DrAtomic/industry-design/README.md

Electronic Hot and cold game

[wiki](https://github.com/DrAtomic/industry-design/wiki)

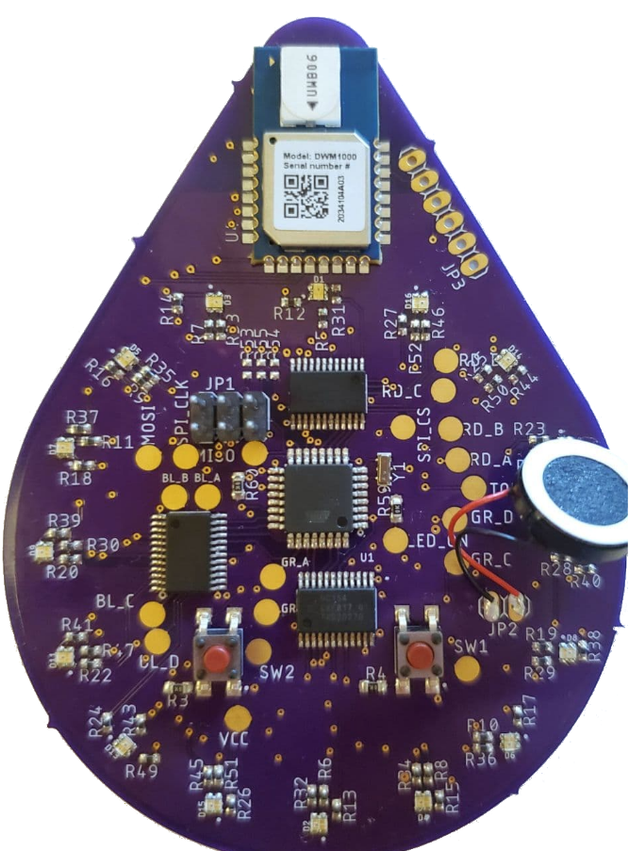
[picture p1: board.png]
board
