DrAtomic/industry-design/slides.pdf

# Electronic Hot and Cold Game

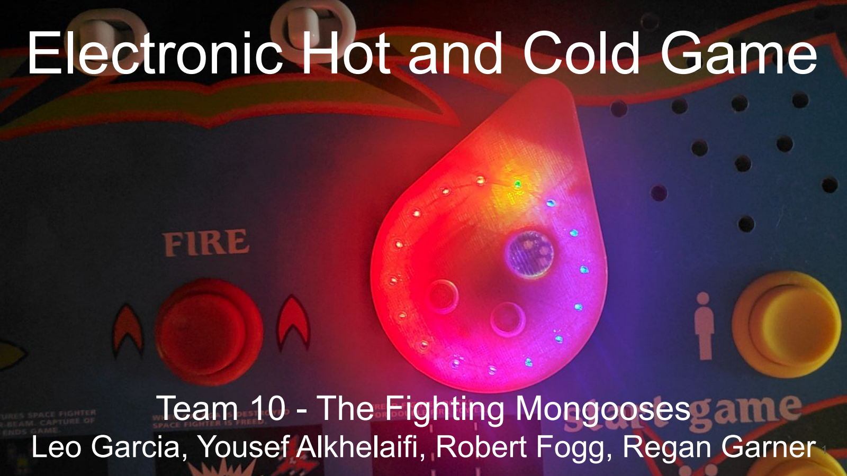
[picture p2: page 1]

# Team 10 - The Fighting Mongooses

# Leo Garcia, Yousef Alkhelaifi, Robert Fogg, Regan Garner 1

# The Problem

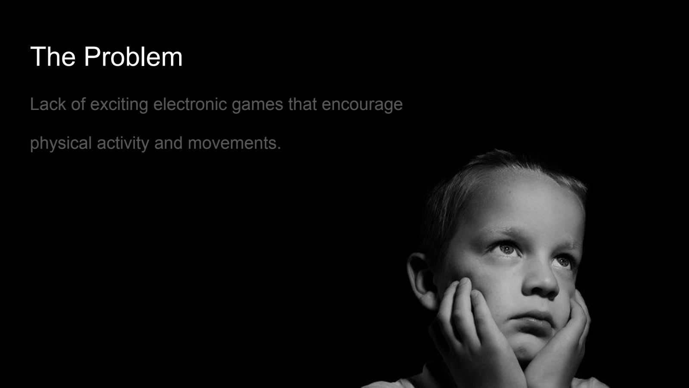
[picture p3: page 2]

## Lack of exciting electronic games that encourage

physical activity and movements.

# Objective: Make an electronic version of the “hot and cold” game

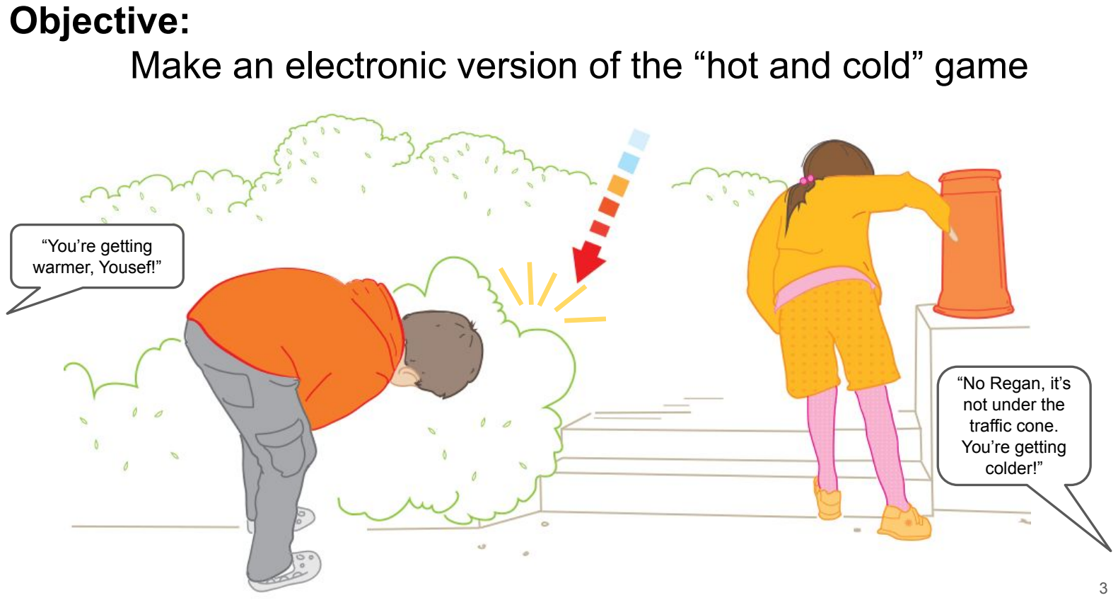
[picture p4: page 3]

“You’re getting
warmer, Yousef!”

“No Regan, it’s
not under the
traffic cone.
You’re getting
colder!”

# Solution

## A portable tracker that can

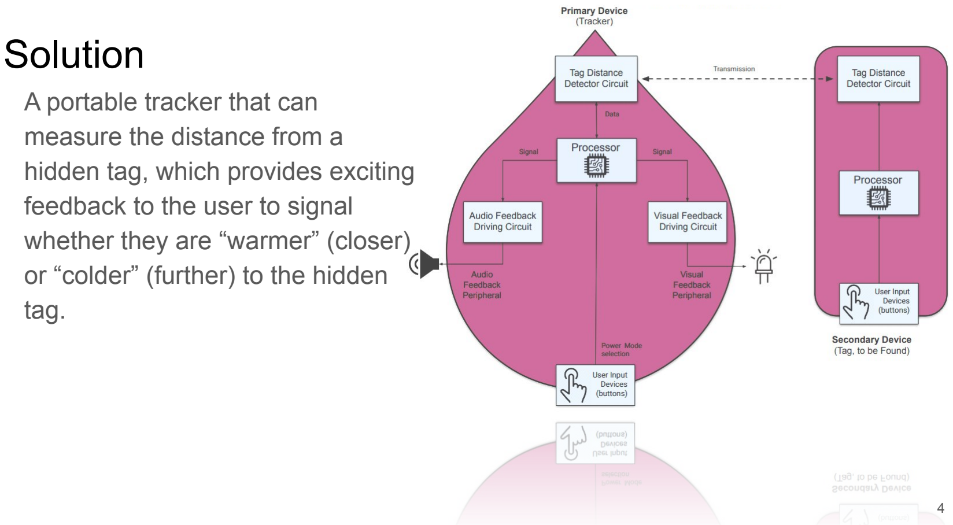
[picture p5: page 4]

## measure the distance from a hidden tag, which provides exciting feedback to the user to signal whether they are “warmer” (closer) or “colder” (further) to the hidden

tag.

# Alternatives:

## Pokemon Go, Geocaching, MicroFox Transmitter Hunting Kits

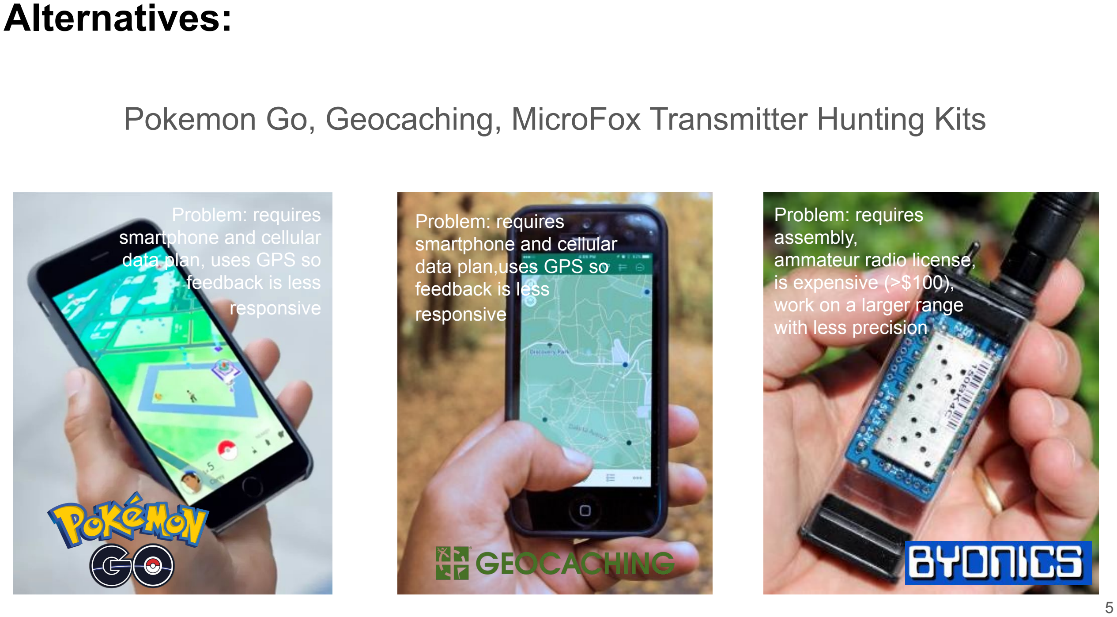
[picture p6: page 5]

Problem: requires
smartphone and cellular
data plan, uses GPS so
feedback is less
responsive

Problem: requires
assembly,
ammateur radio license,
is expensive (>$100),
work on a larger range
with less precision

Problem: requires
smartphone and cellular
data plan,uses GPS so
feedback is less
responsive

# Requirements

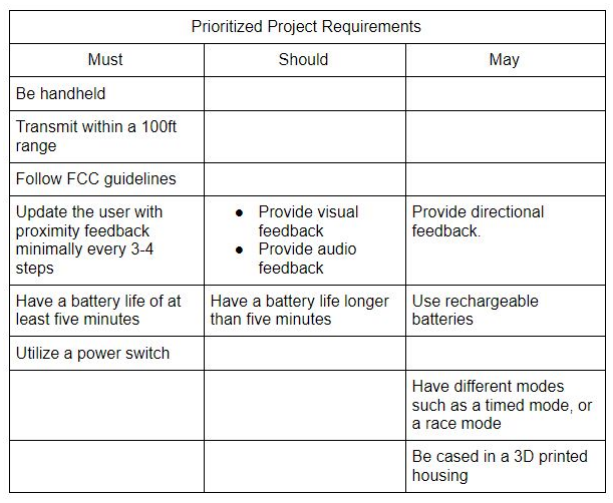
[picture p7: figure]

# Our Approach

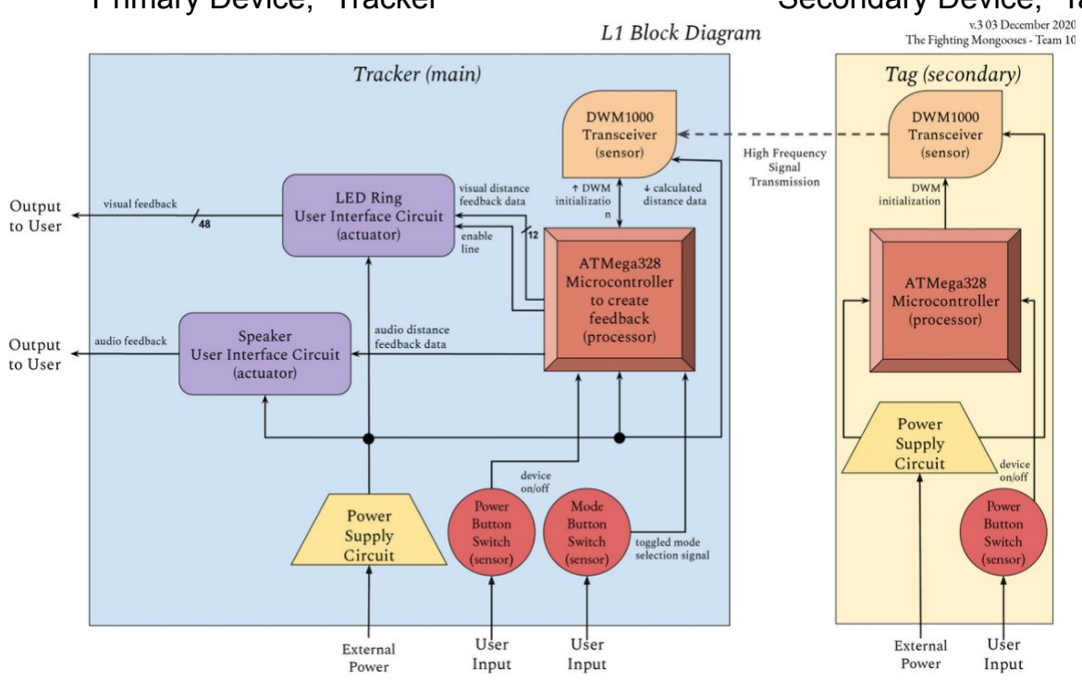
[picture p8: figure]

Primary Device, “Tracker” | Secondary Device, “Tag”

# Design: Power Supply Module

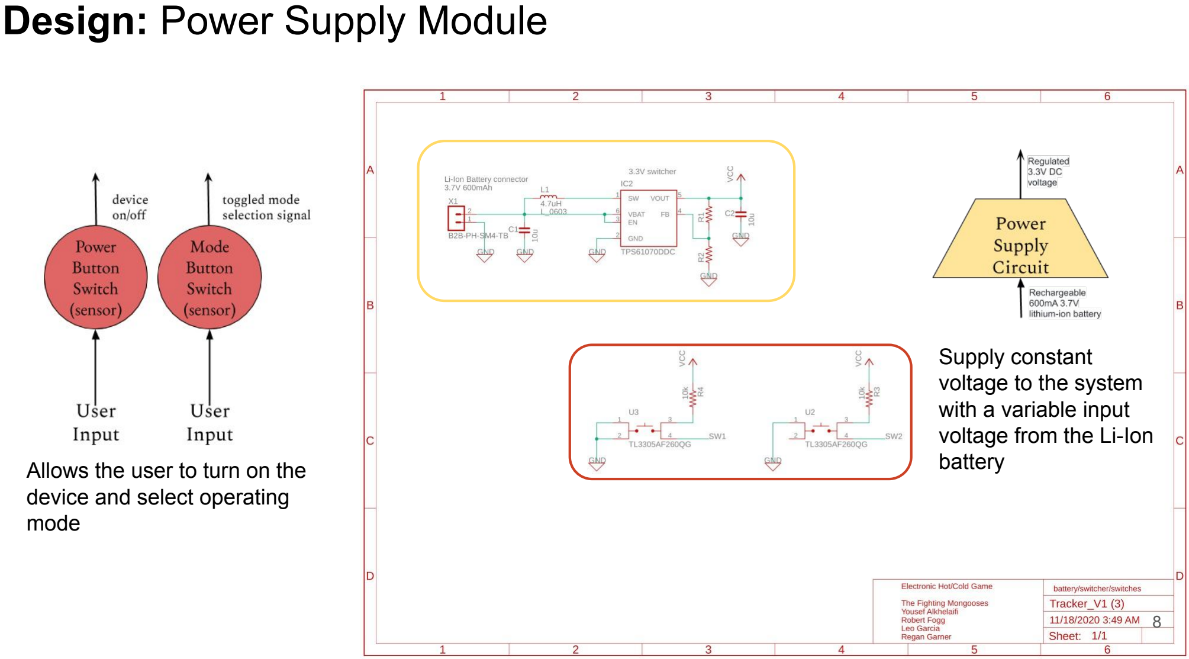
[picture p9: page 8]

Allows the user to turn on the device and select operating mode

Supply constant
voltage to the system
with a variable input
voltage from the Li-Ion
battery

# Design: Processor and Ranging Modules

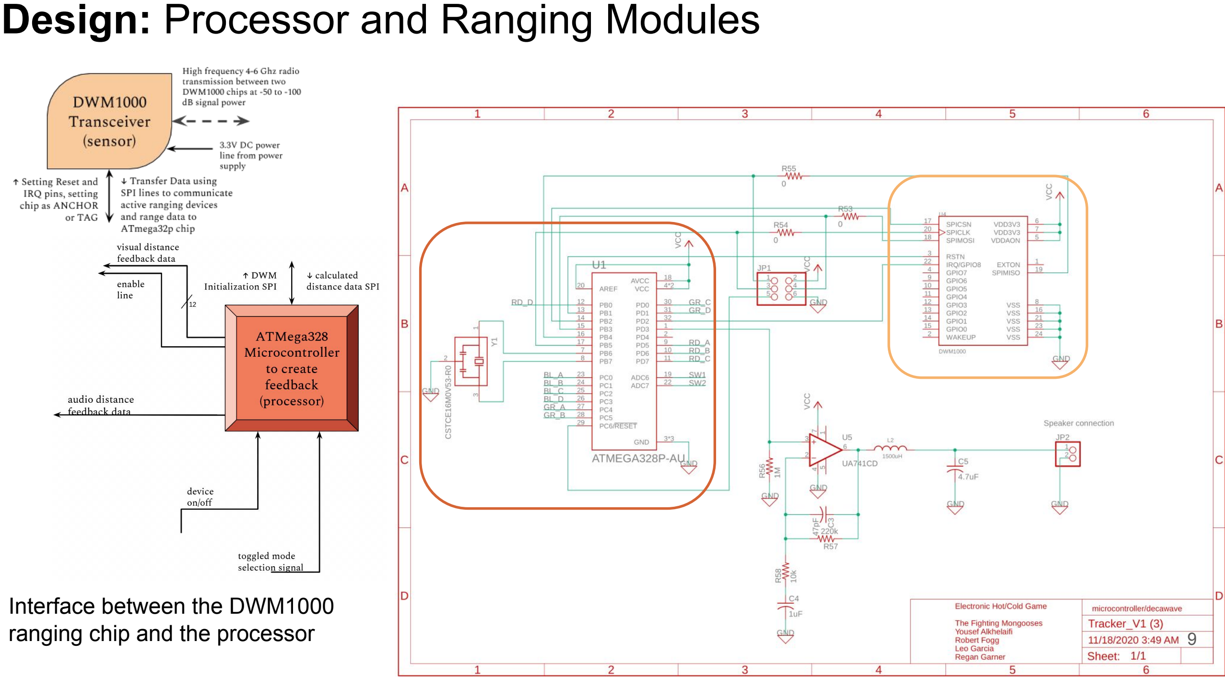
[picture p10: page 9]

Interface between the DWM1000 ranging chip and the processor

# Design: Visual Feedback

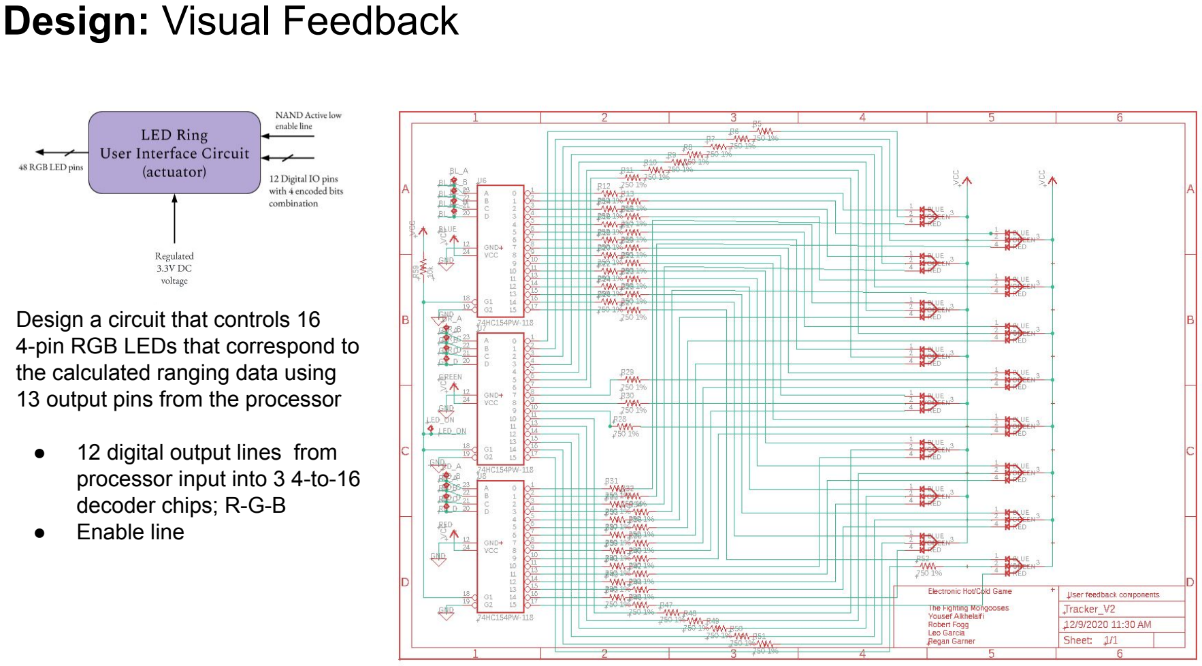
[picture p11: page 10]

Design a circuit that controls 16 4-pin RGB LEDs that correspond to the calculated ranging data using 13 output pins from the processor

- 12 digital output lines from processor input into 3 4-to-16 decoder chips; R-G-B
- Enable line

# Design: Audio Feedback

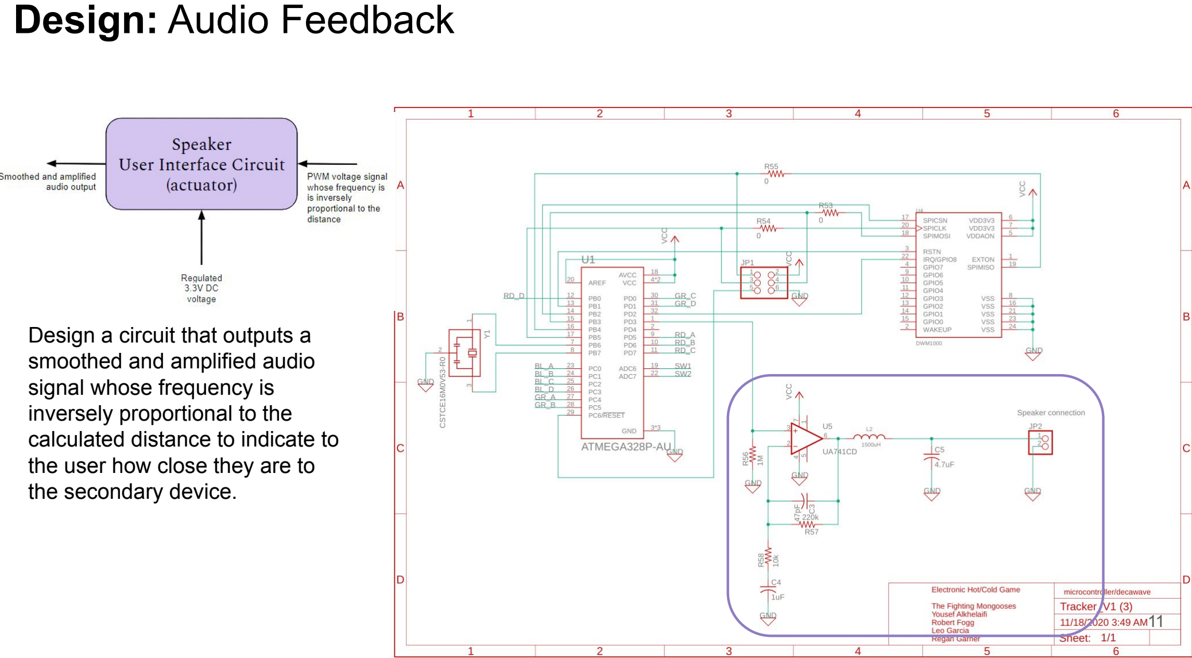
[picture p12: page 11]

Design a circuit that outputs a smoothed and amplified audio signal whose frequency is
inversely proportional to the calculated distance to indicate to the user how close they are to the secondary device.

# Design: Firmware

Challenges:

- Use the DW1000 two-way ranging capabilities to provide stable and usable range data for user feedback, using Dw1000 library.
- Design code that will drive 16 LEDs using 4 pins. By sending 4-bit word to 4x16 decoder, Make the code modular so it can be repeated for all 3 decoders to drive each color of the RGB LED array.
- LED code must be able to select individual LEDs to activate, as well as activate multiple LEDs simultaneously by rotating the selected LEDs in a counter-clock fashion With high enough frequency to appear continuous to the user
- Code must allow the user to interface via 2 buttons
- Driving Speaker with ranging data to be lower at greater distances and higher at closer distance.
LED Feedback Code | Speaker Feedback Code

Arduino-DW1000
interfacing code

Ranging Data

Digital write 4-bit words LED address to Decoder pins, with proper timing.

Output Square wave tone
inversely proportional with distance in frequency

2 Button
interfacing
code

Boolean
conditions

# Implementation: Prototyping

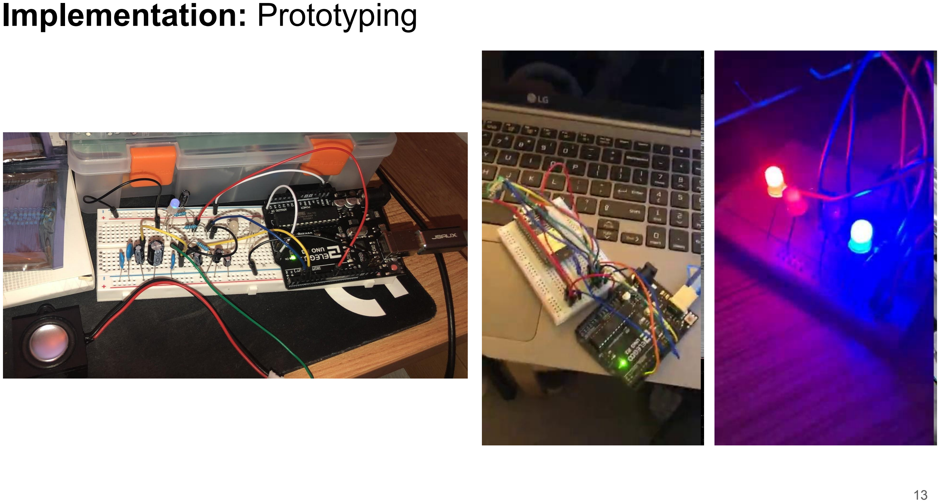
[picture p13: page 13]

# Design: PCB Layout

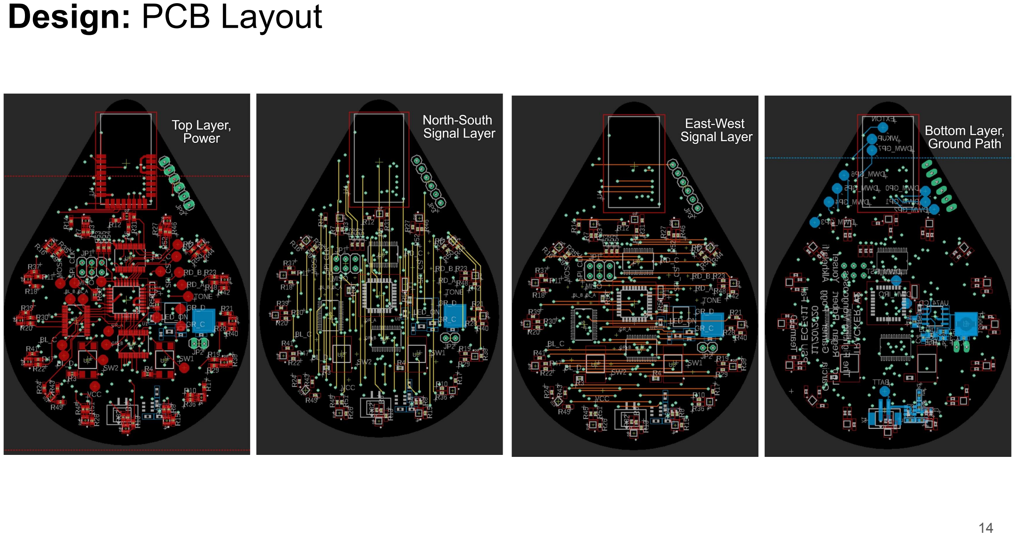
[picture p14: page 14]

# Implementation: Fabricated Boards

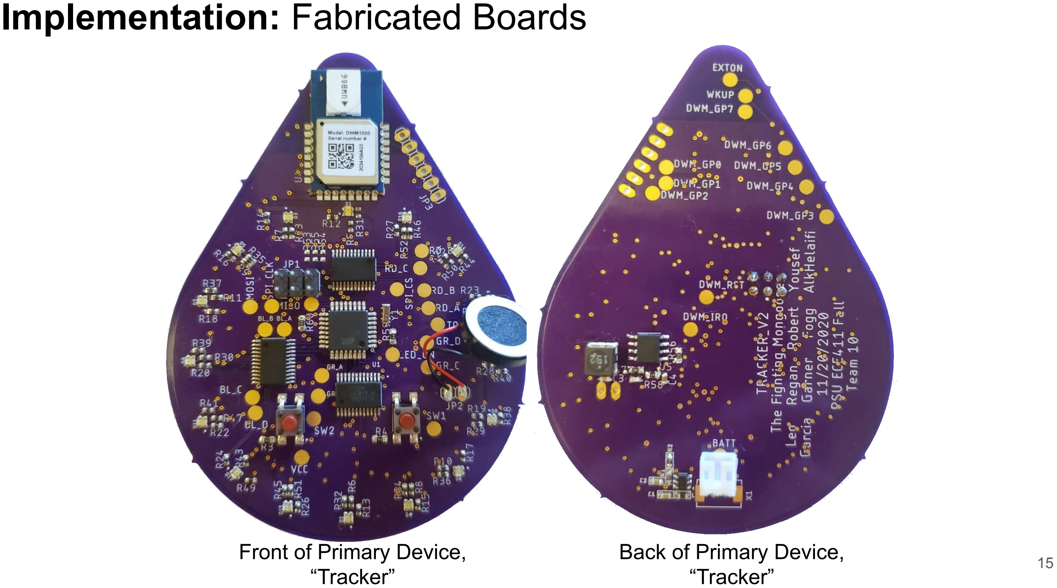
[picture p15: page 15]

Front of Primary Device,
“Tracker”

Back of Primary Device,
“Tracker”

# Implementation: Bill of Materials

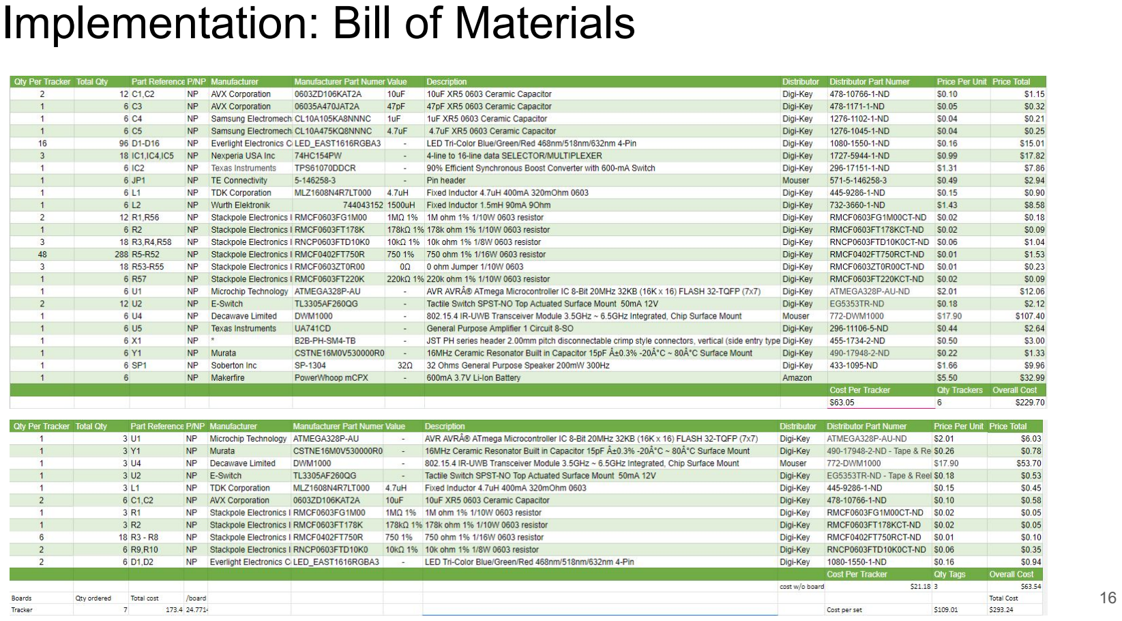
[picture p16: page 16]

# Testing & Results: LED & Speaker functionality

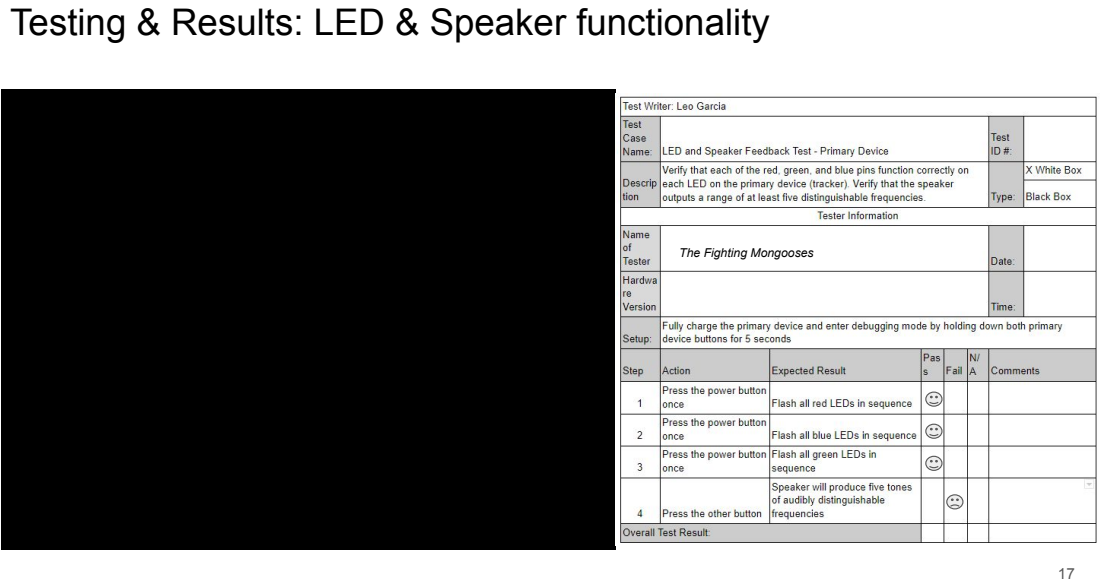
[picture p17: page 17]

The Fighting Mongooses

# Testing & Results: Visual Range Accuracy

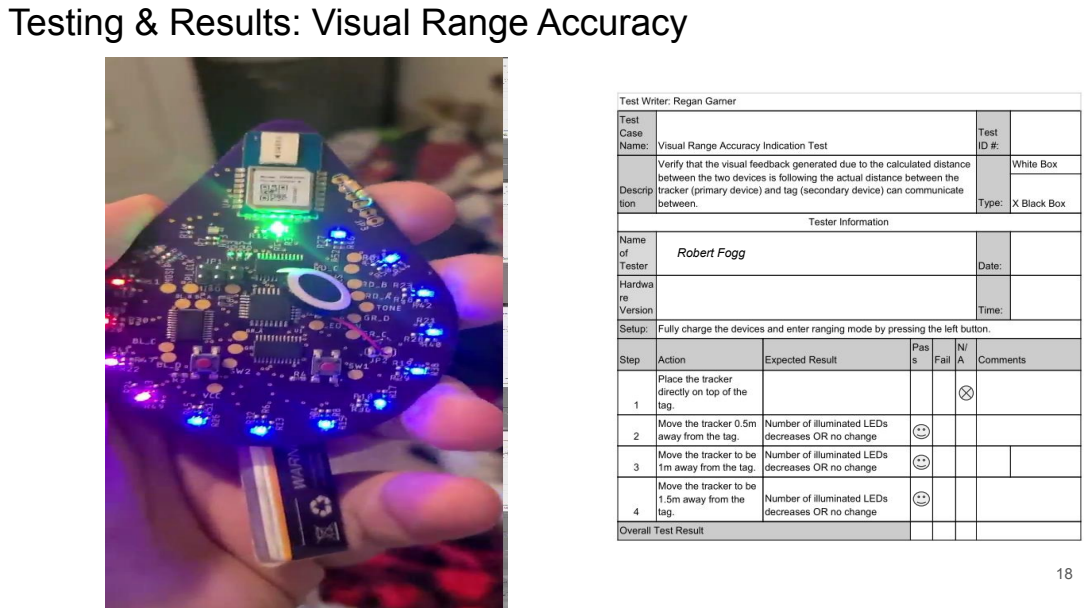
[picture p18: page 18]
Robert Fogg

# Failed Solutions:

## - RF time of flight calculation using simple antenna and Arduino

- (does not work because processor is not fast enough)

## - RSSI relating signal strength to distance using Arduino

- (doesn’t work because there’s too much noise at the legally allowed bandwidth)

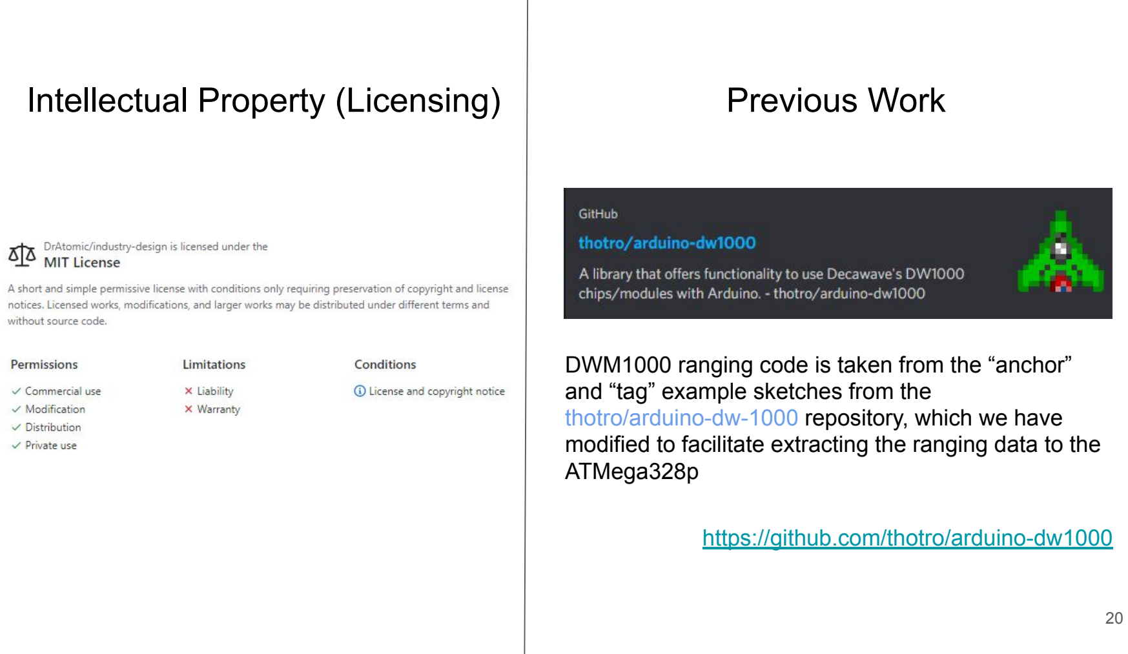
[picture p19: figure]
Intellectual Property (Licensing); and “tag” example sketches from the; ATMega328p; Previous Work

https://github.com/thotro/arduino-dw1000

DWM1000 ranging code is taken from the “anchor”

thotro/arduino-dw-1000 repository, which we have modified to facilitate extracting the ranging data to the

# Contributions

Yousef | Robert | Leo | Regan
- Designed audio
feedback circuit
- Designed visual
feedback circuit
- Wrote feedback
firmware
- Prototyping
- Implementing final
device
- Debugging firmware
- Finalized CAD
schematic
- Finalized CAD PCB
design
- Attached surface
mount components
- Designed and
manufactured 3D
printed cases
- Implementing final
device
- Debugging firmware
- Taught teammates how
to use GitHub
- Initial antenna design
- Managed GitHub
- Contributed to writing
feedback firmware
- Implementing final
device
- Debugging firmware
- Documentation
- Managed Team Wiki
- Initial filter design
- CAD schematic for
initial antenna & filter
design
- CAD schematic rough
draft
- Implementing final
device
- Debugging firmware

# Thank You!

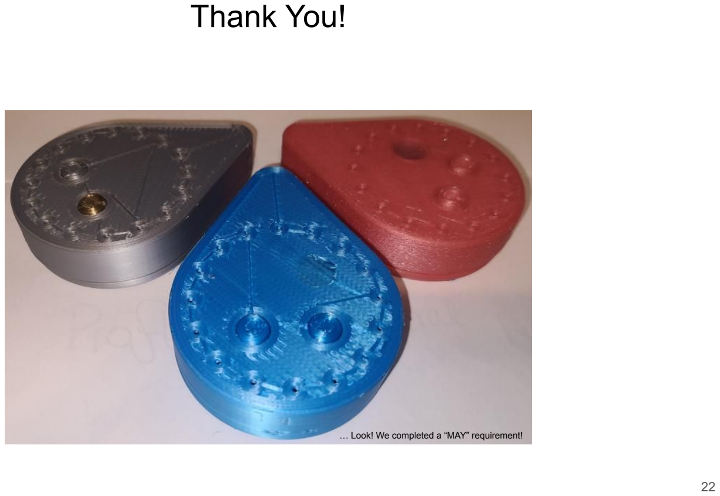
[picture p20: page 22]

… Look! We completed a “MAY” requirement!
