DrAtomic/industry-design/Firmware/LED Sequence Output.PNG

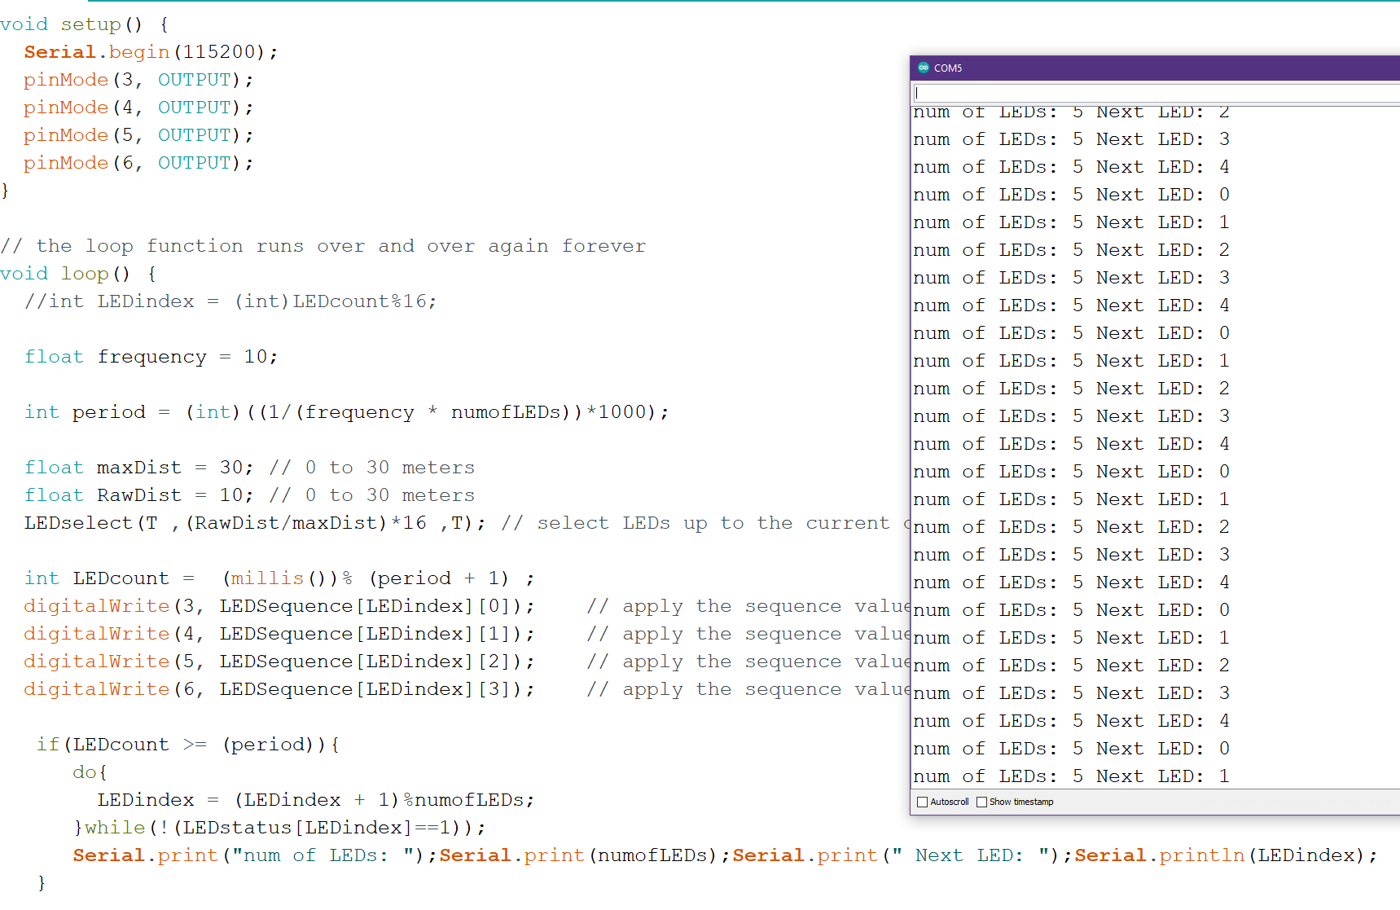
Firmware/LED Sequence Output.PNG
