DrAtomic/industry-design/Firmware/RGBSequence Output.PNG

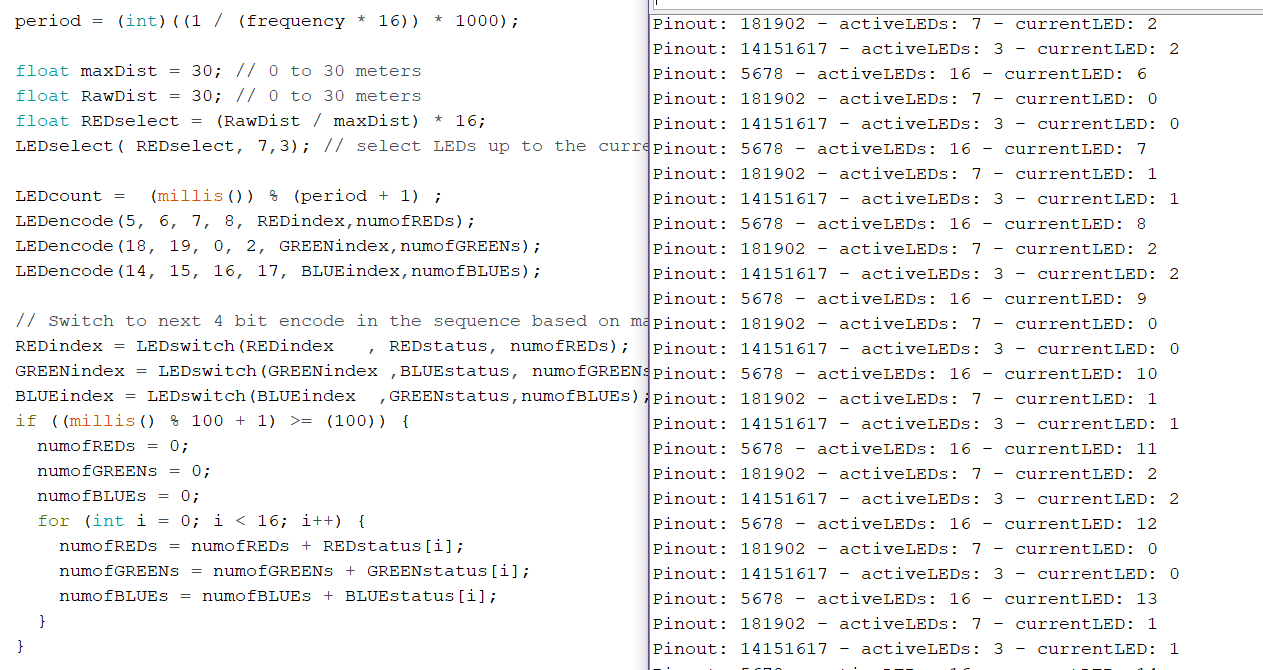
Firmware/RGBSequence Output.PNG
