DrAtomic/industry-design/(threads)

Thread 1 (2020-10-12):

Project Proposal: Janky Simon Says

sundaylimes, 2020-10-12:
Design and build an interactive Simon-says toy. The toy will generate a pseudo-random sequence. It will output each step in the sequence as an LED/sound combination, one step at a time. The user is to mime the sequence. Maybe if the user messes up, the toy will "curse" the user (for lack of a better word), and if the user completes the sequence, then the toy could play some cute 'lil victory sound. Can be held in 3D printed frame, and look like a character we like or something.

It would be cool if we could make it intentionally janky, like messing up the rules of Simon says or something.

Sensor: some number of buttons
Actuator: some number of LED lights, and a speaker
Processor: whichever one is supported this term.

Closed 2020-10-15.

Thread 2 (2020-10-12):

Project Idea: Pet Composer (name is negotiable !)

Yooooos, 2020-10-12:
I suggested a one-off idea if a device that generated a personalized soundtrack, I won't lie I thought it was stupid when I suggested it, but then after a little thought, I found myself intrigued. This is because I realized something like this already exists, kinda. In the latest Zelda game, the soundtrack is ambient and dynamic, the way it works is by checking for certain cues ( time of day, player position, player state, player action, etc...) and then use that information to layer a dynamic soundtrack that seems to react to what's going on on-screen.

So I wonder if something like this can be made in the real world, a device that generates a never-ending ambient soundtrack by being aware of its state and surroundings, and checking for cues, it would be like a lil music composer sitting on your desk, like  ..... a Pet Composer _(TM)_!

Maybe it changes the mood of the music based on the time of day (uplifting in the early morning, melancholic at sunset), maybe it reacts by to what's happening around it by checking for cues from a number of sensors (IR motion detector, accelerometer, microphone ), maybe its plays a jingle when you wag your finger at it, maybe it randomly switches genre to keep things fresh. Maybe when it hears your sad voice telling a story it plays sad violins for dramatic effect (that's a bit of a reach). I will admit I don't have a lot of experience with Hardware so maybe I'm talking nonsense.

The toughest part of this project would be writing code that can generate appealing music with a generous range of variability to convey different moods, tones, tempos, and that can also react be changing quickly but not jarringly. This can be done by taking pre-recorded music and layering is based on sensor/time cues or by actually procedurally generating the music with a random function. Either code only works if the music is non-repeatitive and also reactive, even if it ends up being  8-bit beep bop music. I have experience with coding but not much with coding audio stuff, and probably not much with whatever processor we choose, so I can't accurately estimate how difficult it would be to pull this off.

SENSORS: the more the merrier
ACTUATOR: Speaker
PROCESSOR: anything that can do audio processing

Closed 2020-11-07.

Thread 3 (2020-10-13):

Can counter

DrAtomic, 2020-10-13:
I drink a lot of le croix. You're only allowed to recycle 140 cans a day. So I thought it would be easy to create a can counter. How it would work is that you poor the cans down a hole and the hole is only large enough for one can at a time. Each can gets narrower at each ends. There will be a laser at the end of the hole that is on the edge of the can. The laser will shine through to the other side whenever there is a new can, during the fat part of the can the laser will not shine through. So 2 sensor readings equals to 1 can. The number of cans will be shown by 3 7-segment displays
This proposal will be really simple to implement and it will check all the boxes (I believe)
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

sensor: [photo resistor](https://www.adafruit.com/product/161)
actuator: [7-segmant display](https://www.electronics-tutorials.ws/blog/7-segment-display-tutorial.html)
Processor: this is so simple that it can be done with digital logic and a [counter IC](https://en.wikipedia.org/wiki/Counter_(digital))

Closed 2020-11-07.

Thread 4 (2020-10-13):

Electronic Hot/Cold Game

KrobTheMediocre, 2020-10-13:
2 part design, An emitter "tag" that can be placed somewhere and 1 or more "trackers" that have a RGB LED or audio output that denotes how close to the tag the tracker is. Far away Dark Blue or slow clicks, low tone. As you move closer with the tracker the light changes to "warmer" colors purple, red, orange, yellow, white. Or clicks become faster, higher pitch tone.

SENSORS: Signal intensity meter
ACTUATORS: RGB LED, speaker/buzzer
PROCESSOR: whatever is available

Closed 2020-12-09.

Thread 6 (2020-10-27):

Design a High Q Band-pass Filter Receiver Circuit

sundaylimes, 2020-10-27:
This filter should have a center frequency of approximately 2.4GHz.
For now, leave the gain of the bandpass filter at unity.
We can follow the filter with a simple OpAmp configured to have a variable gain through the use of a variable feedback resistor in order to test how much gain we would like.
Assigned to Regan Garner

sundaylimes, 2020-11-08:
As a group, we have decided to utilize a transceiver to send and receive encrypted messages on both the tracker and tag.
Thus, a bandpass filter is no longer needed.

Closed 2020-11-08.
