DrAtomic/industry-design/feedback/ArduinoAudio3.asc

AnalogWritePin: voltage; PULSE(0 5 0.1m 10n 10n {width} 1m 30)
C1: cap; 680µ
C2: cap; 4.7µ
C3: cap; 68p
C4: cap; 1µ
L1: ind; 15m
L2: ind; 1.5m
Q1: npn
Q2: pnp
R1: res; 6.8
R2: res; 100k
R3: res; 10k
speaker: res; 8
TonePin: voltage; PULSE(0 5 0.1m 10n 10n 0.5m 1m 0); AC 1
U1: UniversalOpamp2
Vcc: voltage; 3.3
Named nets: 0, PWM, DAC, Tone, Out
.tran 0 40m 5m
.step param Width 0m 1m 0.25m
Fighting Mongooses audio amplifier
