DrAtomic/industry-design/BoardFiles/Tracker_V1.brd

## EAGLE design BoardFiles/Tracker_V1.brd (2020-12-06, an earlier design)

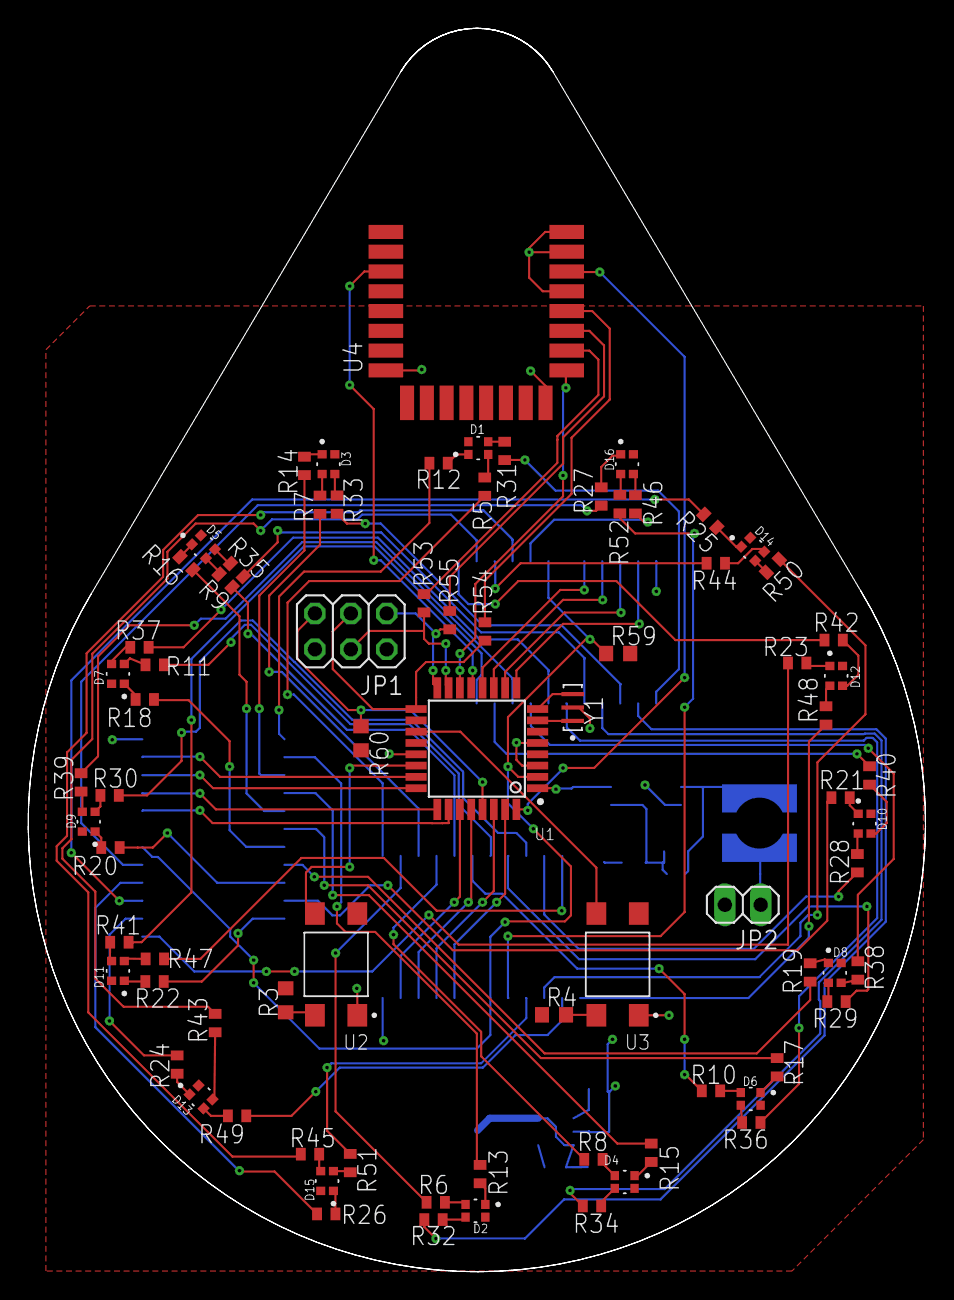
[picture p23: board Tracker_V1.brd from above]

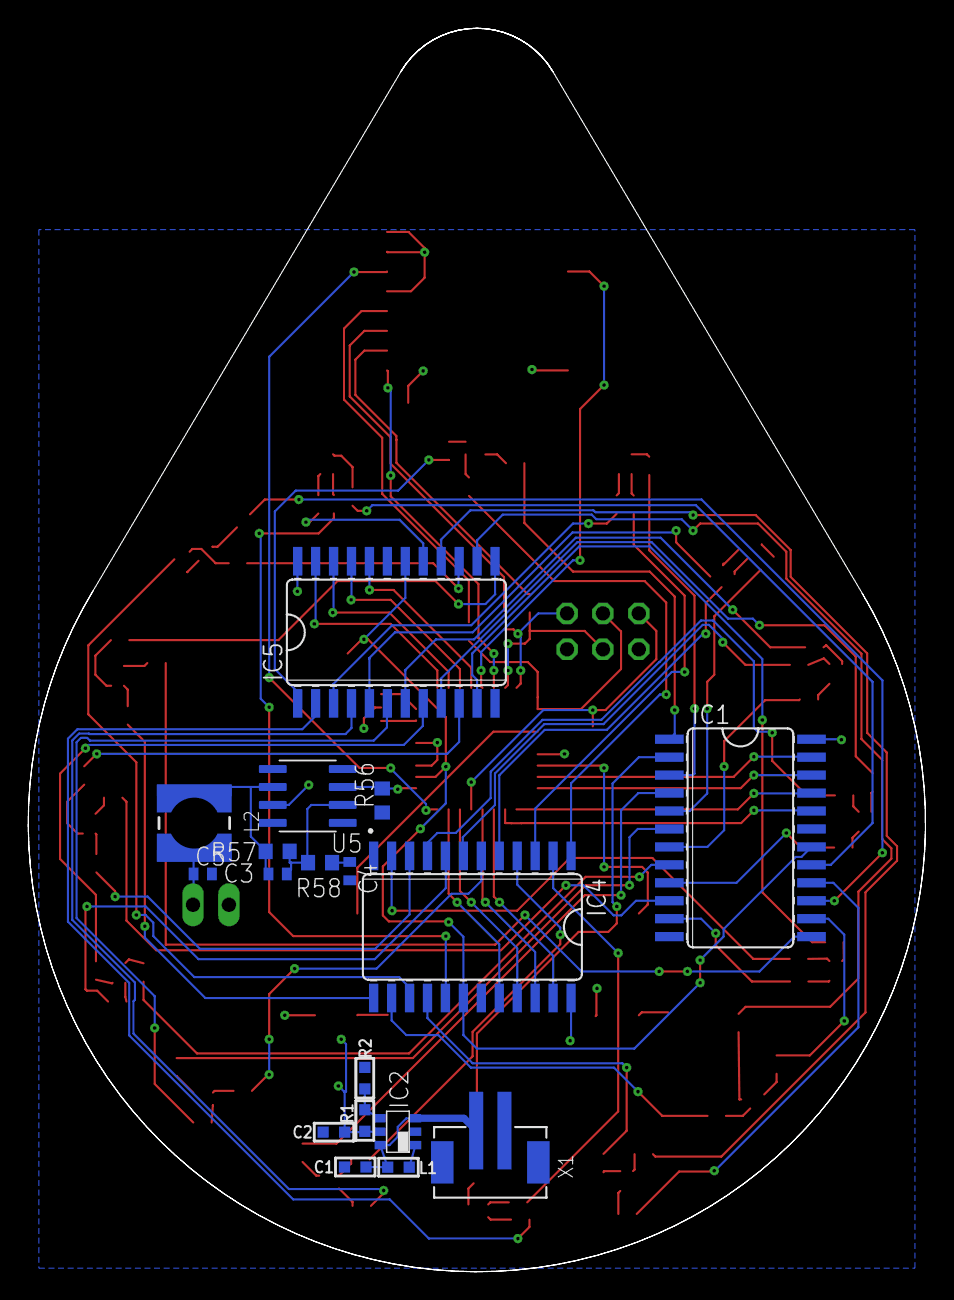
[picture p24: board Tracker_V1.brd from below]

Board: 2 copper layers, 63.5 x 88.0 mm, 96 parts (18 on the bottom side), 135 nets.

Parts:
C1, C2: 10u; C0603
C3: 47pF; C0402
C4: 1uF; C0402
C5: 4.7uF; C0402
D1, D2, D3, D4, D5, D6, D7, D8, D9, D10, D11, D12, D13, D14, D15, D16: LED_EAST1616RGBA3
IC1, IC4, IC5: 74154DW; SO24W
IC2: TPS61070DDC; TSOT23-6_DDC
JP1: 2X03
JP2: 1X02
L1: 4.7u; L0603
L2: 1500uH; WE-TPC_4828
R1, R56: 1M; R0603
R2: 178k; R0603
R3, R4, R58, R59, R60: 10k; R0603
R5, R6, R7, R8, R9, R10, R11, R12, R13, R14, R15, R16, R17, R18, R19, R20, R21, R22, R23, R24, R25, R26, R27, R28, R29, R30, R31, R32, R33, R34, R35, R36, R37, R38, R39, R40, R41, R42, R43, R44, R45, R46, R47, R48, R49, R50, R51, R52: 750 1%; R0402
R53, R54, R55: 0; R0402
R57: 220k; R0603
U1: ATMEGA328P-AU; QFP80P900X900X120-32N
U2, U3: TL3305AF260QG; SW_TL3305AF260QG
U4: DWM1000; XCVR_DWM1000
U5: UA741CD; SOIC127P600X175-8N
X1: B2B-PH-SM4-TB
Y1: CSTCE16M0V53-R0; OSC_CSTCE16M0V53-R0

Connections:
BL_A: IC1.23, U1.23
BL_B: IC1.22, U1.24
BL_C: IC1.21, U1.25
BL_D: IC1.20, U1.26
GND: C1.1, C2.1, C4.2, C5.2, IC1.12, IC1.19, IC2.2, IC4.12, IC4.19, IC5.12, IC5.19, JP1.6, JP2.2, R2.1, R56.1, U1.3, U1.5, U1.21, U2.1, U3.1, U4.8, U4.16, U4.21, U4.23, U4.24, U5.4, X1.1, Y1.2
GR_A: IC4.23, U1.27
GR_B: IC4.22, U1.28
GR_C: IC4.21, U1.30
GR_D: IC4.20, U1.31
LED_ON: IC1.18, IC4.18, IC5.18, R59.1, U1.2
unnamed: IC2.1, L1.1
unnamed: C1.2, IC2.3, IC2.6, L1.2, X1.2
unnamed: R4.2, U3.3
unnamed: D1.1, R12.2
unnamed: R3.2, U2.3
unnamed: IC2.4, R1.1, R2.2
unnamed: D7.1, R18.2
unnamed: D3.1, R14.2
unnamed: D4.1, R15.2
unnamed: D5.1, R16.2
unnamed: D6.1, R17.2
unnamed: D2.1, R13.2
unnamed: D8.1, R19.2
unnamed: D9.1, R20.2
unnamed: D10.1, R21.2
unnamed: D11.1, R22.2
unnamed: D12.1, R23.2
unnamed: D13.1, R24.2
unnamed: D14.1, R25.2
unnamed: D15.1, R26.2
unnamed: D16.1, R27.2
unnamed: IC4.1, R5.1
unnamed: IC4.2, R6.1
unnamed: IC4.3, R7.1
unnamed: D4.2, R8.2
unnamed: D5.2, R9.2
unnamed: D7.2, R11.2
unnamed: D6.2, R10.2
unnamed: D8.2, R29.2
unnamed: D9.2, R30.2
unnamed: IC4.10, R28.1
unnamed: D11.2, R47.2
unnamed: D12.2, R48.2
unnamed: IC4.14, R49.1
unnamed: IC4.15, R50.1
unnamed: IC4.16, R51.1
unnamed: IC4.17, R52.1
unnamed: D16.4, R46.2
unnamed: D15.4, R45.2
unnamed: D14.4, R44.2
unnamed: D13.4, R43.2
unnamed: D12.4, R42.2
unnamed: D11.4, R41.2
unnamed: D10.4, R40.2
unnamed: D9.4, R39.2
unnamed: D8.4, R38.2
unnamed: D7.4, R37.2
unnamed: D6.4, R36.2
unnamed: D5.4, R35.2
unnamed: D4.4, R34.2
unnamed: D3.4, R33.2
unnamed: D2.4, R32.2
unnamed: D1.4, R31.2
unnamed: D1.2, R5.2
unnamed: D2.2, R6.2
unnamed: D3.2, R7.2
unnamed: IC4.4, R8.1
unnamed: IC4.5, R9.1
unnamed: IC4.6, R10.1
unnamed: IC4.7, R11.1
unnamed: IC1.1, R12.1
unnamed: IC1.2, R13.1
unnamed: IC1.3, R14.1
unnamed: IC1.4, R15.1
unnamed: IC1.5, R16.1
unnamed: IC1.6, R17.1
unnamed: IC1.7, R18.1
unnamed: IC1.8, R19.1
unnamed: IC1.9, R20.1
unnamed: IC1.10, R21.1
unnamed: IC1.11, R22.1
unnamed: IC1.13, R23.1
unnamed: IC1.14, R24.1
unnamed: IC1.15, R25.1
unnamed: IC1.16, R26.1
unnamed: IC1.17, R27.1
unnamed: IC4.8, R29.1
unnamed: IC4.9, R30.1
unnamed: D10.2, R28.2
unnamed: IC5.1, R31.1
unnamed: IC5.2, R32.1
unnamed: IC5.3, R33.1
unnamed: IC5.4, R34.1
unnamed: IC5.5, R35.1
unnamed: IC5.6, R36.1
unnamed: IC5.7, R37.1
unnamed: IC5.8, R38.1
unnamed: IC5.9, R39.1
unnamed: IC5.10, R40.1
unnamed: IC5.11, R41.1
unnamed: IC5.13, R42.1
unnamed: IC5.14, R43.1
unnamed: IC5.15, R44.1
unnamed: IC5.16, R45.1
unnamed: IC5.17, R46.1
unnamed: IC4.11, R47.1
unnamed: IC4.13, R48.1
unnamed: D13.2, R49.2
unnamed: D14.2, R50.2
unnamed: D15.2, R51.2
unnamed: D16.2, R52.2
unnamed: U1.14, U4.17
unnamed: JP1.4, R53.1, U1.15
unnamed: JP1.1, R55.1, U1.16
unnamed: JP1.3, R54.1, U1.17
unnamed: U1.13, U4.3
unnamed: U1.32, U4.22
unnamed: U1.8, Y1.3
unnamed: U1.7, Y1.1
unnamed: JP1.5, R60.1, U1.29
unnamed: R53.2, U4.18
unnamed: R54.2, U4.20
unnamed: R55.2, U4.19
unnamed: R56.2, U1.1, U5.3
unnamed: C3.1, L2.1, R57.1, U5.6
unnamed: C5.1, JP2.1, L2.2
unnamed: C3.2, R57.2, R58.2, U5.2
unnamed: C4.1, R58.1
RD_A: IC5.23, U1.9
RD_B: IC5.22, U1.10
RD_C: IC5.21, U1.11
RD_D: IC5.20, U1.12
SW1: U1.19, U3.4
SW2: U1.22, U2.4
VCC: C2.2, D1.3, D2.3, D3.3, D4.3, D5.3, D6.3, D7.3, D8.3, D9.3, D10.3, D11.3, D12.3, D13.3, D14.3, D15.3, D16.3, IC1.24, IC2.5, IC4.24, IC5.24, JP1.2, R1.2, R3.1, R4.1, R59.2, R60.2, U1.4, U1.6, U1.18, U1.20, U4.5, U4.6, U4.7, U5.7
