DrAtomic/industry-design/schematics/Tracker/ECE411_13Nov.sch

## KiCad design schematics/Tracker/ECE411_13Nov.sch (2020-11-14)

Schematic: ECE411_13Nov.sch

Parts:
C2: 680u; C_0603_1608Metric
C3: 68p; C_0603_1608Metric
C4: 1u; C_0603_1608Metric
C5: 4.7u; C_0603_1608Metric
DWM1: DWM1000
L1: 15m; L_0603_1608Metric
L2: 1.5m; L_0603_1608Metric
Q1: 2N3904; TO-92_Inline
Q2: 2N3906; TO-92_Inline
R3: 6.8; R_0603_1608Metric
R4: 100k; R_0603_1608Metric
R5: 10k; R_0603_1608Metric
S1: 8
U1: ATMEGA328-AUR; QFP80P900X900X120-32N
U3: LM741

Notes on the sheet:
TRACKER SCHEMATIC
