DrAtomic/industry-design/schematics/Tracker/ECE411_14Nov.sch

## KiCad design schematics/Tracker/ECE411_14Nov.sch (2020-11-15)

Schematic: ECE411_14Nov.sch

Parts:
C2: 680u; C_0603_1608Metric
C3: 68p; C_0603_1608Metric
C4: 1u; C_0603_1608Metric
C5: 4.7u; C_0603_1608Metric
D1, D2, D3, D4, D5, D6, D7, D8, D9, D10, D11, D12, D13, D14, D15, D16: DIODE; D_0603_1608Metric
DWM1: DWM1000
IC1: 74HC154D,653; SOIC127P1032X265-24N; Manufacturer_Part_Number 74HC154D,653; Mouser Part Number 771-74HC154D-T
L1: 15m; L_0603_1608Metric
L2: 1.5m; L_0603_1608Metric
Q1: 2N3904; TO-92_Inline
Q2: 2N3906; TO-92_Inline
R3: 6.8; R_0603_1608Metric
R4: 100k; R_0603_1608Metric
R5: 10k; R_0603_1608Metric
S1: 8
U1: ATMEGA328-AUR; QFP80P900X900X120-32N
U3: LM741

Notes on the sheet:
TRACKER SCHEMATIC
