DrAtomic/industry-design/(commit log)

2020-11-14 Revert "Final speaker driver circuit completed"
2020-11-29 adding LED sequence Arduino code
2020-12-04 LEDsequence version 2
