DrAtomic/industry-design/(notices)

Notices in the files:
parts and their libraries:
rc-master-smd: Copyright (C) 2007, Bob Starr
Eagle_WE-TPC_rev19a: Copyright: Würth Elektronik
